ESE519/Phantom/(commit log)

2013-12-15 added muscle sensor implementation and PPT implementation into project
2013-12-19 Added some functions
    Added IMU library, PPT control function, canon function,roubtler
    control function
2013-12-22 Added Quadrotor part code and updated IMU library
